KMcNickel/HH-DMX-Console-Hardware/Handheld DMX Console V3 DMX/Default Configuration/Outputs/ExportSTEP/PCB.step

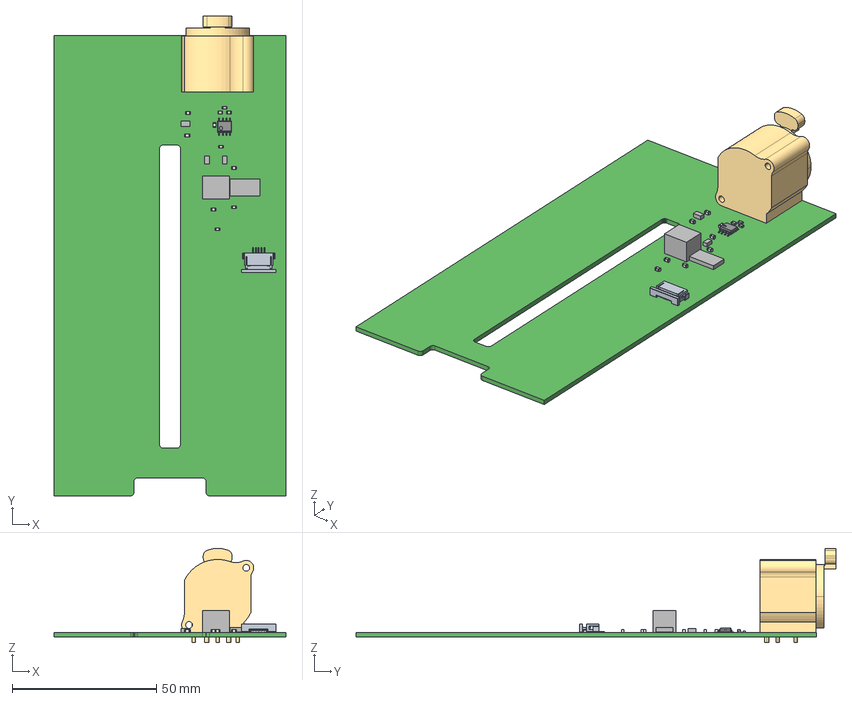
[picture p1: CAD file, 2020-08-16]
Handheld DMX Console V3 DMX/Default Configuration/Outputs/ExportSTEP/PCB.step
80.4 x 166.3 x 32.6 mm
Board
3-D_NC5FAH
Extruded x 38
BODY_M08A_35
LEAD_M08A_57 x 8
MANIFOLD_SOLID_BREP_2784
MANIFOLD_SOLID_BREP_2935
MANIFOLD_SOLID_BREP_3086
MANIFOLD_SOLID_BREP_3237
