KMcNickel/HH-DMX-Console-Hardware/HH DMX Console - Membrane Keypad PCB Alternative/Default Configuration/Outputs/ExportSTEP/PCB.step

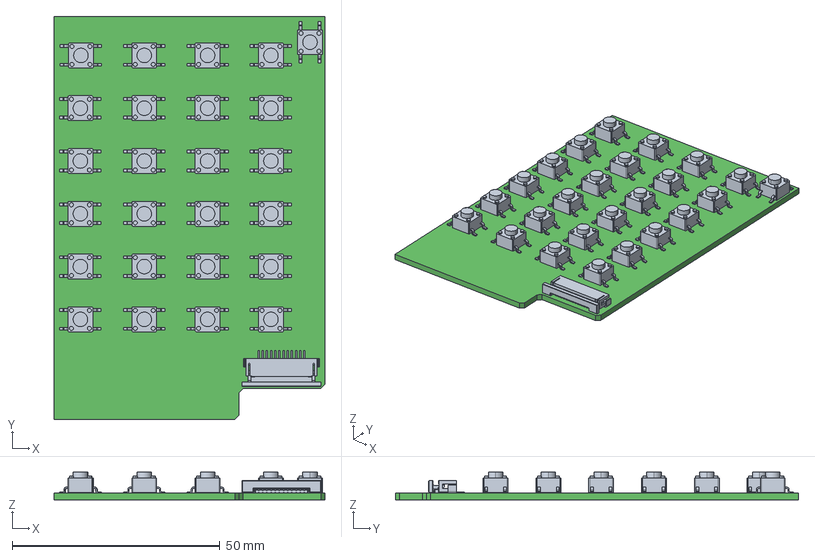
[picture p2: CAD file, 2020-08-16]
HH DMX Console - Membrane Keypad PCB Alternative/Default Configuration/Outputs/ExportSTEP/PCB.step
65.2 x 97.0 x 6.73 mm
Board
c-4-1437565-1-s-3d x 25
