KMcNickel/HH-DMX-Console-Hardware/HH DMX Console - Membrane Keypad PCB Alternative/Default Configuration/Outputs/HH DMX Console - Membrane Keypad PCB Alternative.PDF

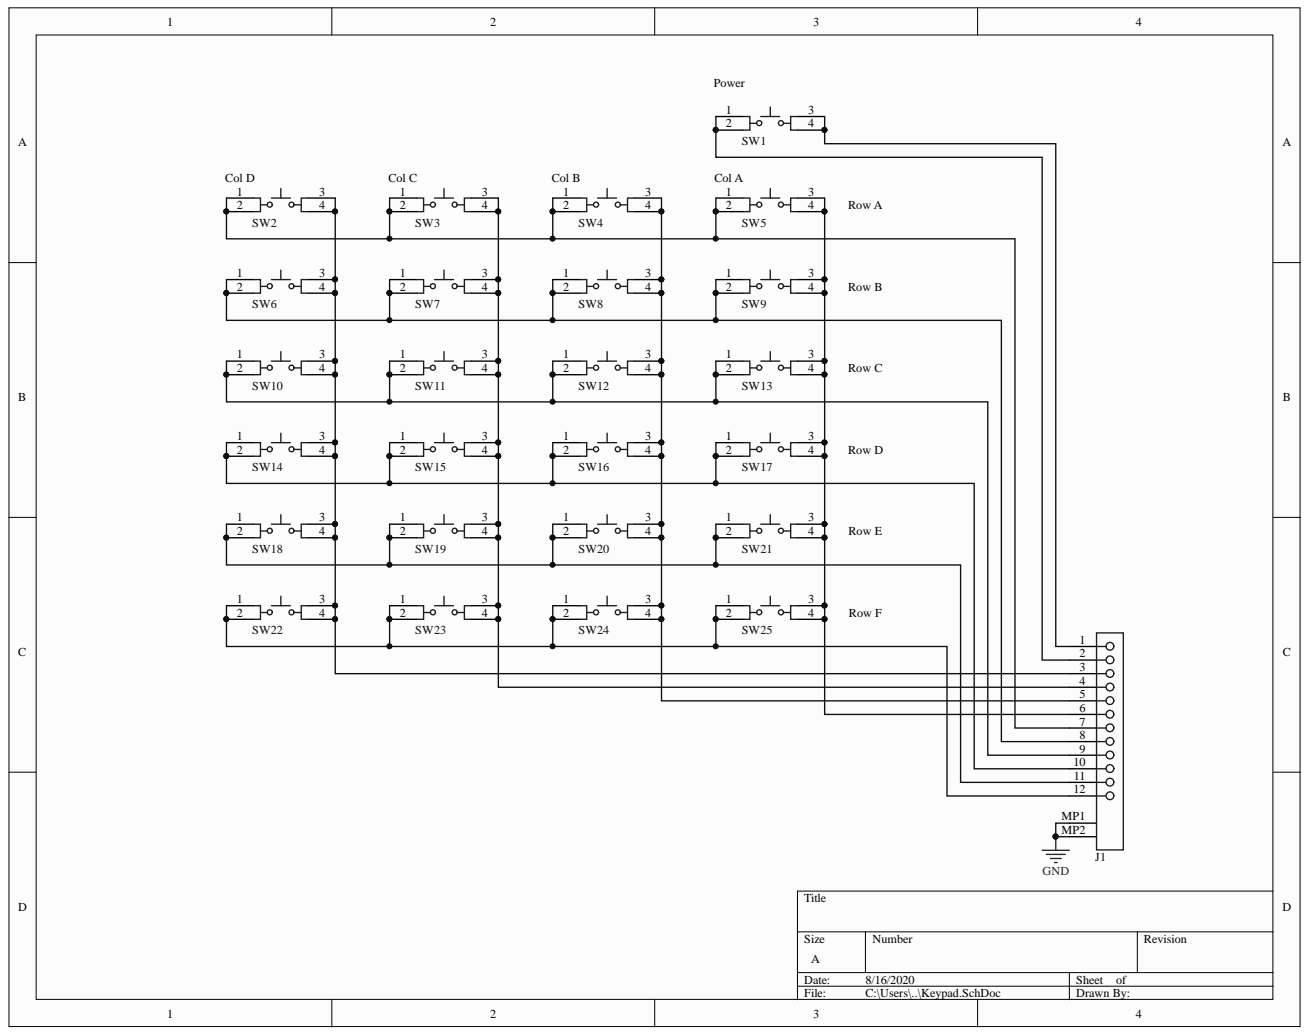
[picture p12: page 1]

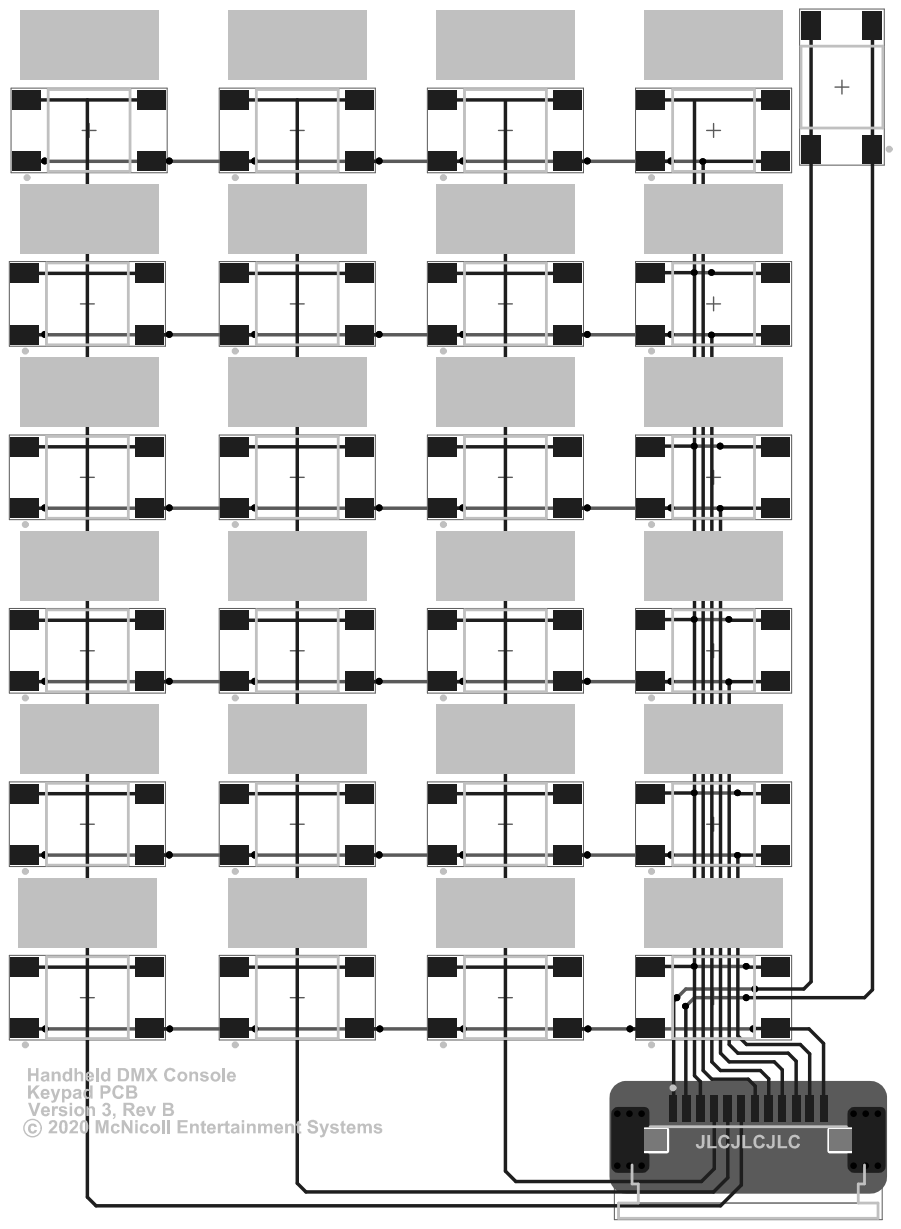
[picture p13: page 2]
