KMcNickel/HH-DMX-Console-Hardware/(list of files, drawings)

Other design files:
Handheld DMX Console - V3/DMX.SchDoc
Handheld DMX Console - V3/Handheld DMX Console - V3.PrjPcb
Handheld DMX Console - V3/MCU.SchDoc
Handheld DMX Console - V3/Power V2.SchDoc
Handheld DMX Console - V3/Power.SchDoc
Handheld DMX Console - V3/User Interface.SchDoc
Handheld DMX Console V3 DMX/DMX.SchDoc
Handheld DMX Console V3 DMX/Handheld DMX Console V3 DMX.PrjPcb
HH DMX Console - Membrane Keypad PCB Alternative/HH DMX Console - Membrane Keypad PCB Alternative.PrjPcb
HH DMX Console - Membrane Keypad PCB Alternative/Keypad.SchDoc
