KMcNickel/HH-DMX-Console-Hardware/(threads)

Thread 1 (2020-08-06):

LTC3101 falling out of regulation

KMcNickel, 2020-08-06:
RESET pin is being asserted. Likely caused by the device being stuck in Burst Mode (Pin 1 held low) and too much current being drawn

Adding additional capacitance, reducing feedback resistors, and removing output capacitance did not help.

Still need to test forcing Pin 1 high

KMcNickel, 2020-08-07:
Wiring Pin 1 to VCC instead of GND fixed the issue. Can be closed after schematic is fixed.

Closed 2020-08-13.

Thread 2 (2020-08-06):

Keypad PCB does not have the FFC slot

KMcNickel, 2020-08-06:
Need to add lines to the outline layer to indicate the location of the slot so it will be exported to the gerbers

Closed 2020-08-13.

Thread 3 (2020-08-06):

USB-C connector not compatible with case

KMcNickel, 2020-08-06:
USB-C connector is designed to be flush mounted to the end of the PCB and does not have the stick-out required to work with the case

KMcNickel, 2020-08-07:
Also note that the current Dual row SMT connector shorted the D+ and D- pins when soldered, an effect of pins I cant see.

KMcNickel, 2020-08-08:
DX07B024XJ1R1300 from JAE appears to be a good candidate

KMcNickel, 2020-08-08:
DX07S024XJ1R1100 is also an option. Both connectors should be set back from the edge of the PCB to provide a little more mechanical strength for the mating plug.

KMcNickel, 2020-08-10:
Choosing the Bel SS-52400-003 pending final review

Closed 2020-08-13.

Thread 4 (2020-08-06):

FFC for keypad needs to move

KMcNickel, 2020-08-06:
The FFC connector should move to face the bottom of the board to allow easier assembly. Exact location, pcb cuts, and case modifications are yet to be determined

Closed 2020-08-13.

Thread 5 (2020-08-06):

Battery connector need to move

KMcNickel, 2020-08-06:
Battery in connector should move toward the bottom to facilitate easier assembly. Ensure large traces to reduce inductance.

KMcNickel, 2020-08-13:
cabd048ee2edacbe9550007fd66e43b19f7418f8

Closes this.

Closed 2020-08-13.

Thread 6 (2020-08-06):

PWRON pull-up needs to be removed/modified

KMcNickel, 2020-08-06:
Removing the pull up prevents the capacitance from re-enabling the LTC3101 after the MCU shuts off.

If a shorter button press is desired to turn the unit on, the PWRON pin can be shorted to the RESET pin and a pull-up can be added. HOWEVER, an investigation must be done to determine if there will be an issue with the SWD reset connection.

One thought is this: If the PWRON is entirely dependent on the MCU, the power button must be held down during programming (SWD or USB). If the PWRON is tied to reset, the button will only need to be held during SWD programming, the unit should stay on by itself during USB programming.

KMcNickel, 2020-08-06:
STM32 has an internal typ. 40K pull-up resistor. The LTC3101 RESET is open-drain. Simply tying PWRON to reset may be enough. In this case, the MCU cannot pull PWRON low until the button has been released or it will turn back on. This can be part of the shutdown process.

Press and hold button -> shutdown begins by notifying user and completing shutdown tasks -> when shutdown tasks are complete AND button is released, pull PWRON down.

KMcNickel, 2020-08-10:
Tying PWRON to RESET does nnot work. The MCU goes into reset when the line falls to 1.32V, while the LTC3101 stays enabled.

Maybe, a schottky diode followed by a bypass capacitor feedinng the MCU reset line. Capacitor would need to be small enough to not affect the LTC3101 reset

KMcNickel, 2020-08-10:
With a 10K pull-up on PWRON (not connected to RESET),, the PWRON signal only drops to 1.04V

KMcNickel, 2020-08-10:
Idea: A D-Flip Flop (like SN74LVC1G80) with CLK connected to the MCU output and D, Q`,  and PWRON connected together. This may be problematic if the output cannot be defined prior to the first rising edge from the MCU

KMcNickel, 2020-08-10:
Use SN74LVC1G175 and tie the CLEAR pin to RESET to clear it while the MCU is resetting

KMcNickel, 2020-08-13:
Consider tying the Preset pin to RESET and the Clear pin High to enable the flip flop when the reset is pulsed. That would fix the issue of having to hold the button during SWD programming

Closed 2020-08-13.

Thread 7 (2020-08-06):

DMX FFC is mis-wired

KMcNickel, 2020-08-06:
Pins 1 - 5 are swapped  between the Main and DMX boards

Closed 2020-08-13.

Thread 8 (2020-08-06):

DMX Connector Wired Incorrectly

KMcNickel, 2020-08-06:
Pins 2 and 3 need to swap

Closed 2020-08-13.

Thread 10 (2020-08-15):

PCBs should be 159.5mm

KMcNickel, 2020-08-15:
Update from 159.15mm

 - [x] Main PCB
 - [x] DMX PCB

KMcNickel, 2020-08-15:
Closed. Commit 92c7410673a8a5e557658798c4f9adabec09bb0c

Closed 2020-08-15.

Thread 11 (2020-09-10):

Needs Reverse Voltage Protection

KMcNickel, 2020-09-10:
Putting the batteries in backwards kills the LTC3101

KMcNickel, 2020-09-11:
Add an LM66100

KMcNickel, 2020-09-18:
Testing with the LM66100 fixes the issue
