KMcNickel/HH-DMX-Console-Hardware/(commit log)

2020-08-13 PWRON Flip Flop Added
    Closes #6
    Chose to tie CLR to RESET, this might swap to PRE.
    [Handheld DMX Console - V3.PrjPcb, Power.SchDoc]
2020-08-13 Moved Keypad and Battery Connnectors
    Relocated connnectors for easier assembly / disassembly. Closes #4 and #5
2020-08-13 USB Connector Replaced
    Closes #3
    [MCU.SchDoc, Power.SchDoc]
2020-08-13 DMX Connector Rewired
    Closes #8
    Pins 2 annd 3 swapped
    [DMX.SchDoc, Handheld DMX Console V3 DMX.PrjPcb]
2020-08-13 FFC Slot added to Keypad
    Closes #2
    Added FFC Slot to outline layer
2020-08-13 Changed LTC3101 Regulator Mode
    Closes #1
    PWM pin has been moved to VMAX
    [Power.SchDoc]
2020-08-13 DMX board FFC rewired
    Closes #7
    Swapped the pinout on the FFC connnector from the DMX board
    [DMX.SchDoc]
2020-08-13 DMX Transciever Update
    Changed RS-485 Transciever and added ESD Diode
    [DMX.SchDoc]
2020-08-13 Generated All Outputs
    [BOM_PartType-Handheld DMX Console - V3.xlsx, BOM_PartType-Handheld DMX Console V3 DMX.xlsx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]
2020-08-13 Adjusted Keypad Dimensions
    Keypad PCB has been shrunk to 65.2mm wide to better fit the enclosure. Outputs Generated
    [Handheld DMX Console - V3.PrjPcb, Handheld DMX Console V3 DMX.PrjPcb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]
2020-08-13 Keypad PCB Updated
    FFC connnector moved to correct position.
    Outputs Generated
    [HH DMX Console - Membrane Keypad PCB Alternative.PrjPcb, PCB.step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]
2020-08-15 Modified Board Dimensions
    Adjusted Main annd DMX PCB outer dimensions to 159.5mm x 80.4mm
    [BOM_PartType-Handheld DMX Console - V3.xlsx, BOM_PartType-Handheld DMX Console V3 DMX.xlsx, HH DMX Console - Membrane Keypad PCB Alternative.PrjPcb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]
2020-08-15 Silkkscreen Added
    Closes #9
    Silkscreen Identifiers have been added to all three PCBs
    [BOM_PartType-Handheld DMX Console - V3.xlsx, BOM_PartType-Handheld DMX Console V3 DMX.xlsx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]
2020-08-15 Fixed Silkkscreen Markings
    Now indicates Rev B, instead of Rev A
    [BOM_PartType-Handheld DMX Console - V3.xlsx, BOM_PartType-Handheld DMX Console V3 DMX.xlsx, PCB.step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]
2020-08-16 Ran DRC and GGenerated Outputs
    Zip files for PCB manufacturing were put together. Two DRC rules were added to the Main PCB file to eliminate related DRC Errors.
    [BOM_PartType-Handheld DMX Console - V3.xlsx, BOM_PartType-Handheld DMX Console V3 DMX.xlsx, HH DMX Console - Membrane Keypad PCB Alternative.PrjPcb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]
2020-08-16 Updated Project FIles
    [HH DMX Console - Membrane Keypad PCB Alternative.PrjPcb, Handheld DMX Console - V3.PrjPcb, Handheld DMX Console V3 DMX.PrjPcb]
2020-08-16 Switched back to THVD2410
    Decided that the cost / simplicity of just a THVD2410 was better
    [BOM_PartType-Handheld DMX Console V3 DMX.xlsx, DMX.SchDoc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]
2020-08-16 Added Silkscreen Order Number Marker
    Added Indicators to hide order numbers from JLCPCB under parts
    [BOM_PartType-Handheld DMX Console - V3.xlsx, BOM_PartType-Handheld DMX Console V3 DMX.xlsx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]
